msiecinski/Minisumo/README.md

# Minisumo
Source file, pcb and stl files.

## Design assumptions:
- 4 wheels
- STM32H753VIT6 MCU
- used start module
- 10 x 10 cm
- 500 g
- 4 x pololu HPCB 15:1 6V motor
- 4 x encoders(1 for each wheel)
- 6 x sharp sensor(GP2Y0D340K)
- 3 x ktir sensor
