msiecinski/Minisumo/Mechanics/README.md

# List of mechanical elements
- chassis(SLDPRT and STL)
- plow(SLDPRT and STL)
- submission(SLDPRT and STL)
