msiecinski/Minisumo/PCB/README.md

# List of PCBs
- sharp board
- main board
