msiecinski/Minisumo/Mechanics/submission.SLDASM

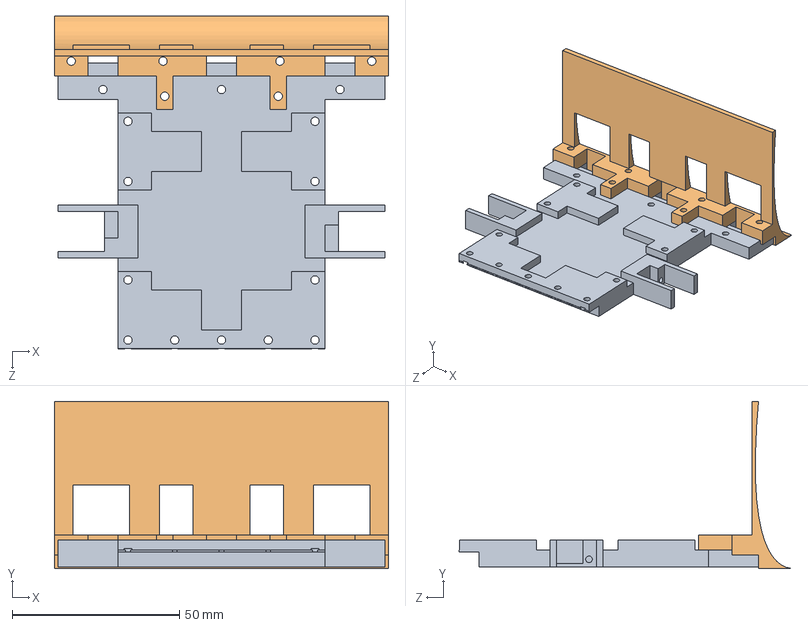
[picture p1: CAD file, 2022-06-03]
Mechanics/submission.SLDASM
100.0 x 50.0 x 99.7 mm
chassis
plow
