msiecinski/Minisumo/Mechanics/chassis.SLDPRT

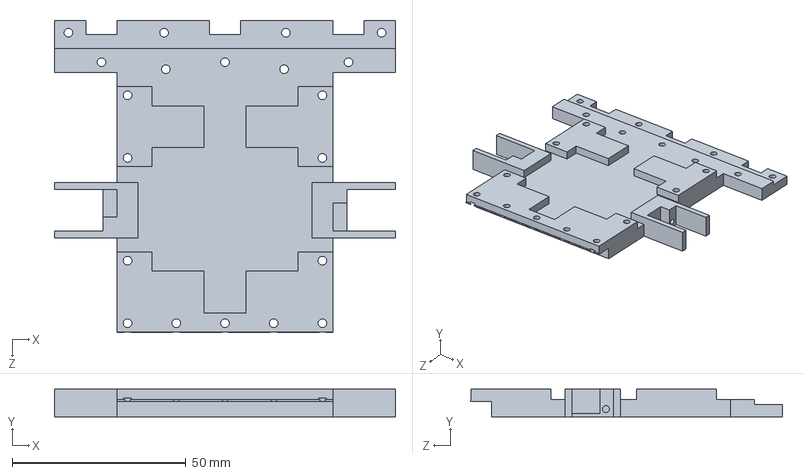
[picture p2: CAD file, 2022-06-03]
Mechanics/chassis.SLDPRT
98.0 x 8.00 x 89.6 mm
