msiecinski/Minisumo/Mechanics/plow.SLDPRT

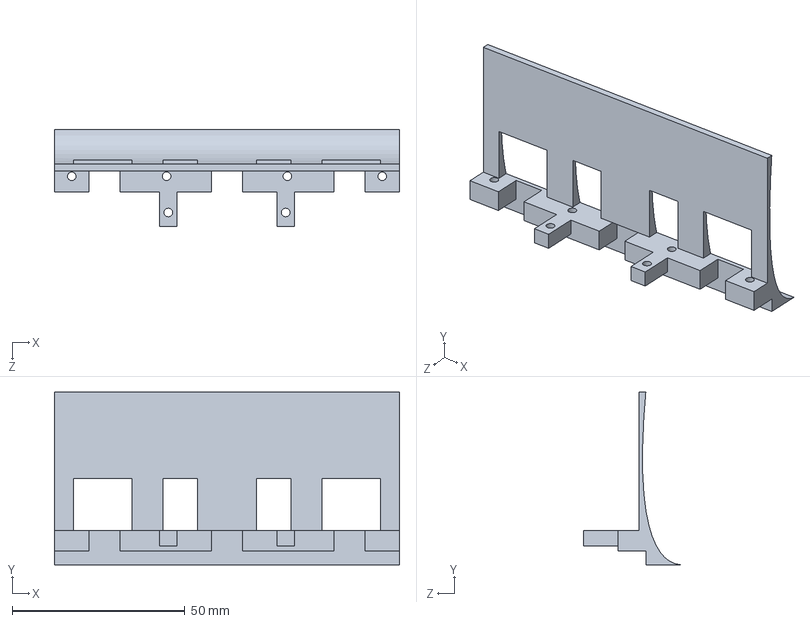
[picture p3: CAD file, 2022-06-03]
Mechanics/plow.SLDPRT
100.0 x 50.0 x 28.0 mm
