msiecinski/Minisumo/Mechanics/chassis_v2.SLDPRT

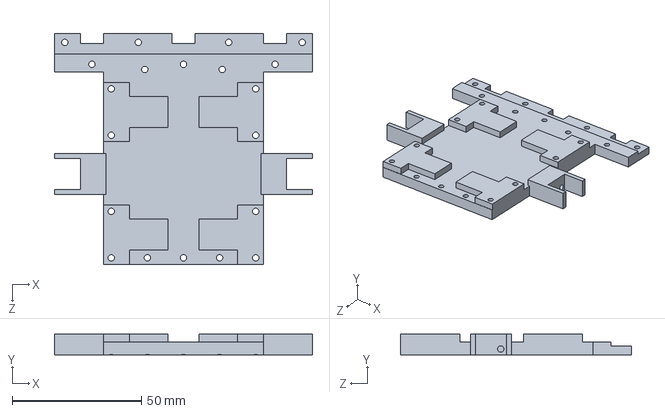
[picture p4: CAD file, 2021-10-17, an earlier design]
Mechanics/chassis_v2.SLDPRT
100.0 x 8.00 x 89.6 mm
