msiecinski/Minisumo/(list of files, cad)

Other CAD files:
Mechanics/chassis.STL
Mechanics/chassis_v2.STL
Mechanics/plow.STL
Mechanics/submission.STL
