msiecinski/Minisumo/PCB/MainBoard/MainBoard.brd

## EAGLE design PCB/MainBoard/MainBoard.brd (2022-07-14)

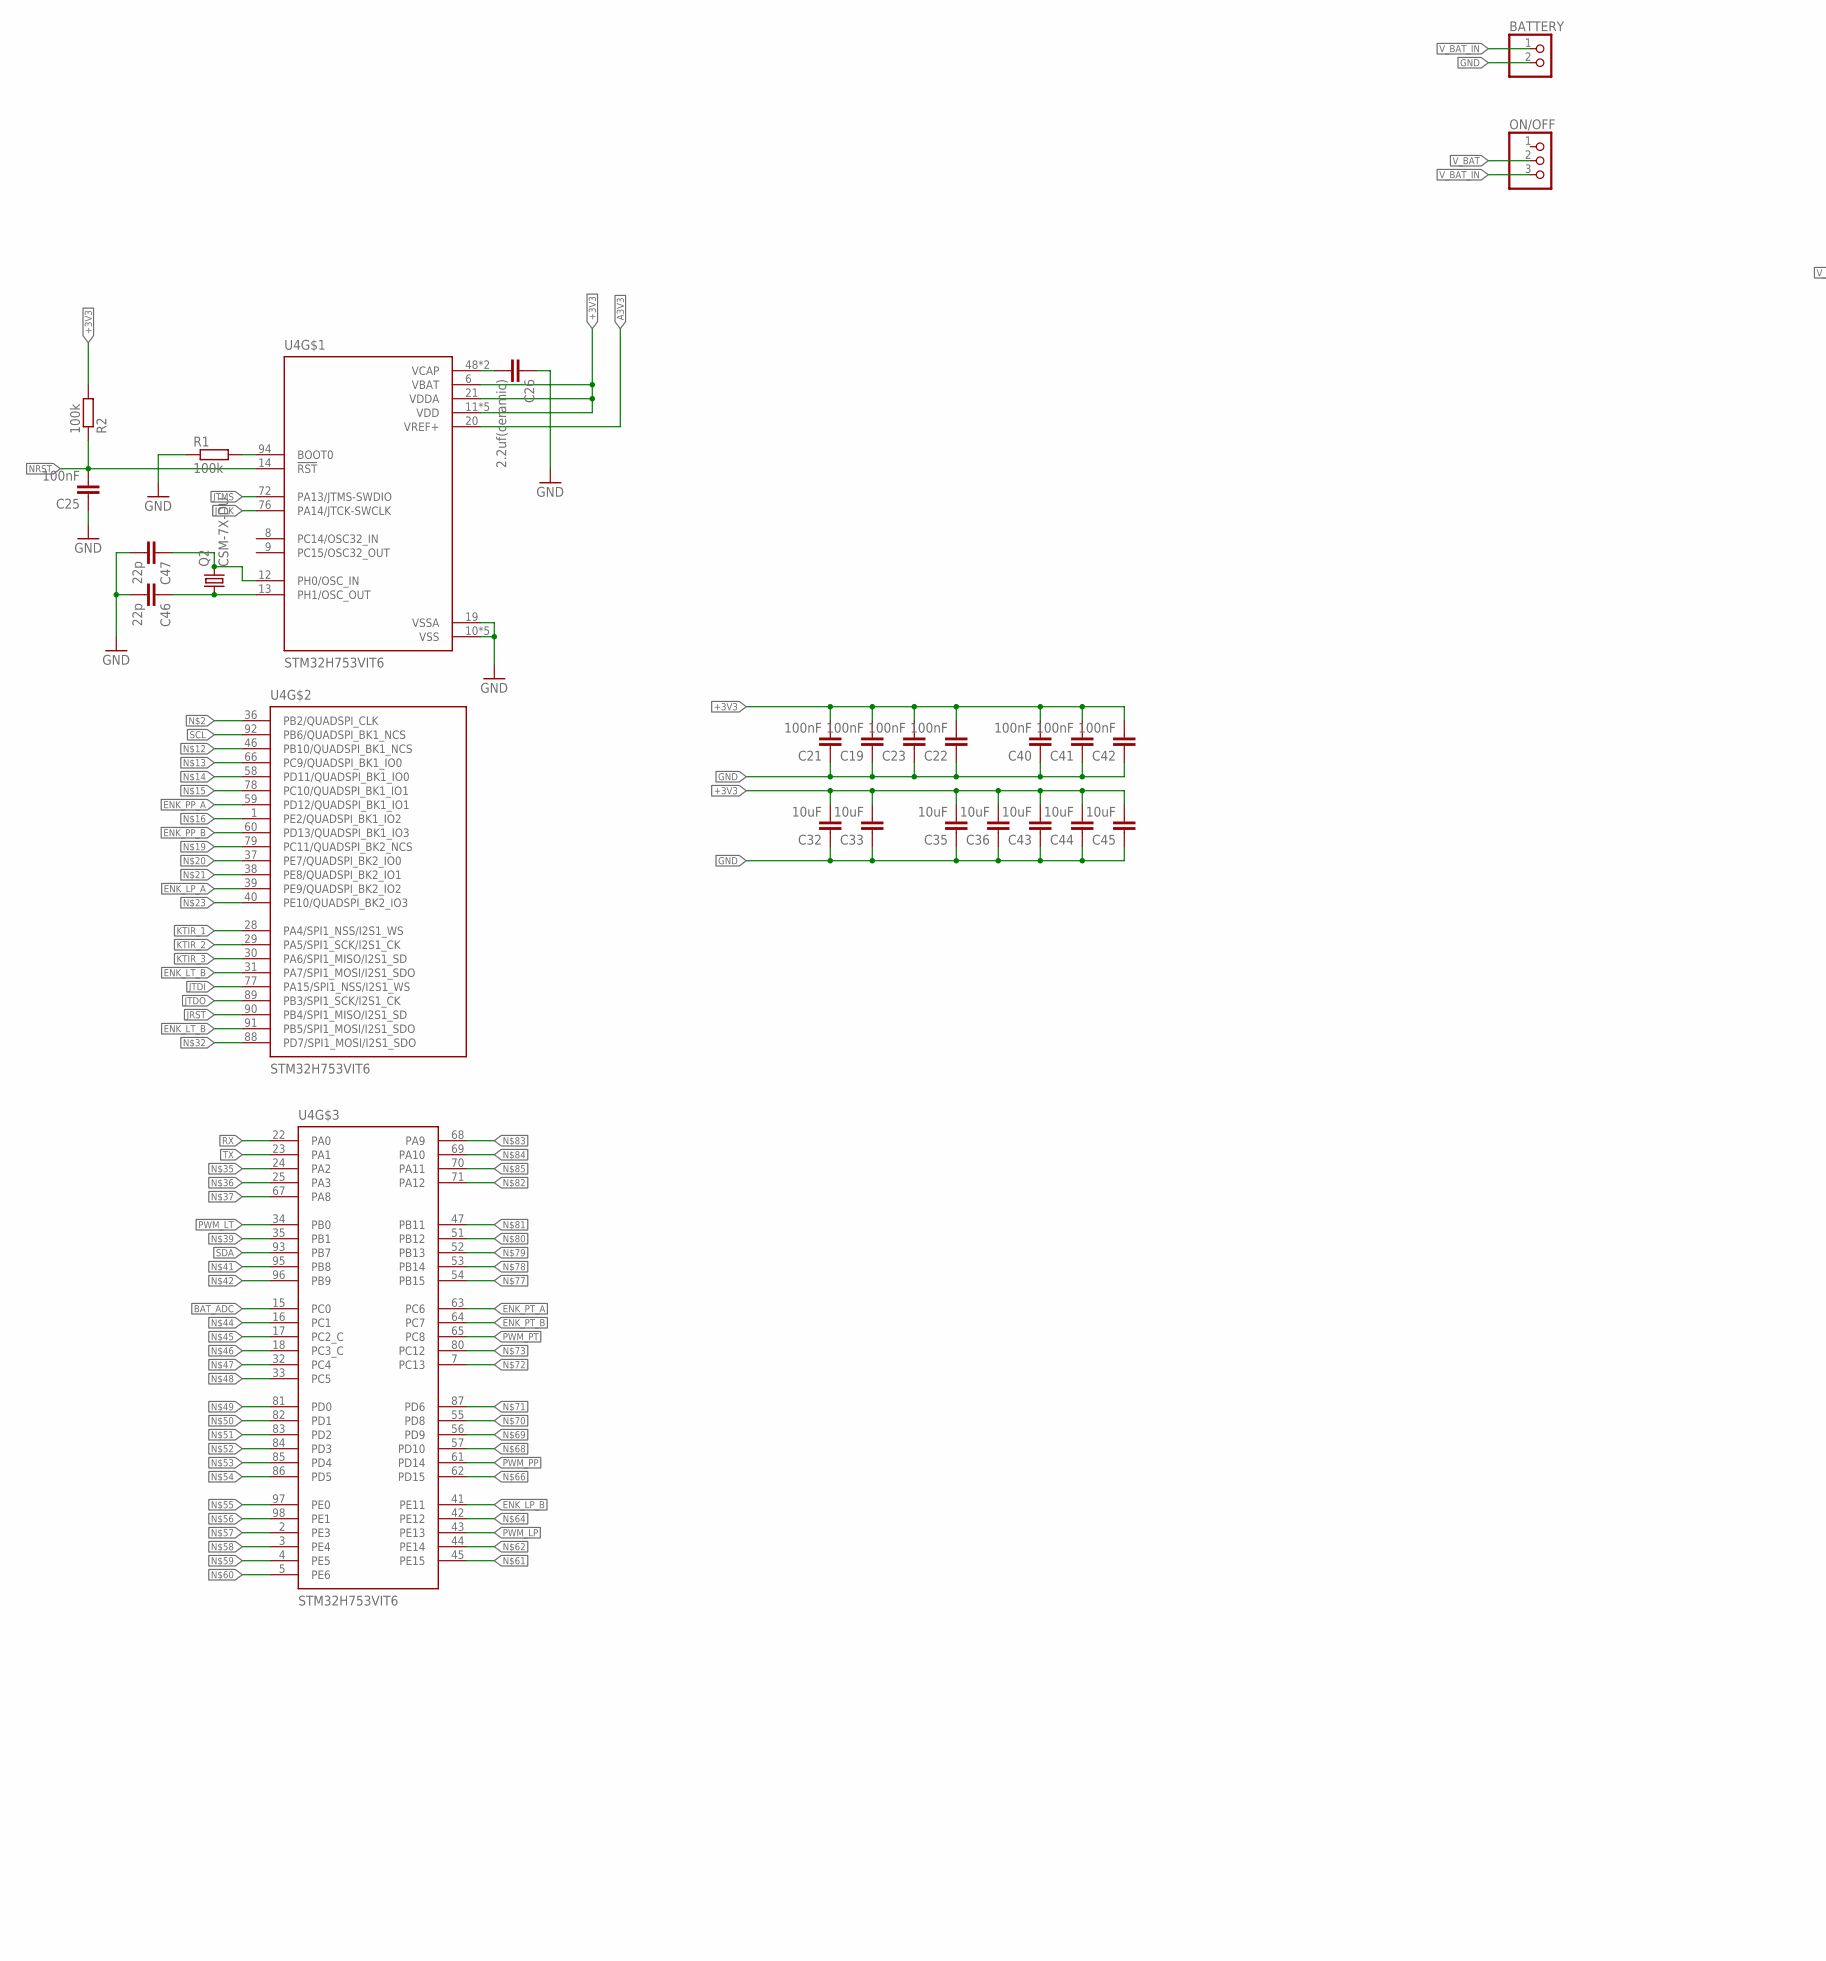
[picture p5: schematic MainBoard.sch, part in row 1, column 1]

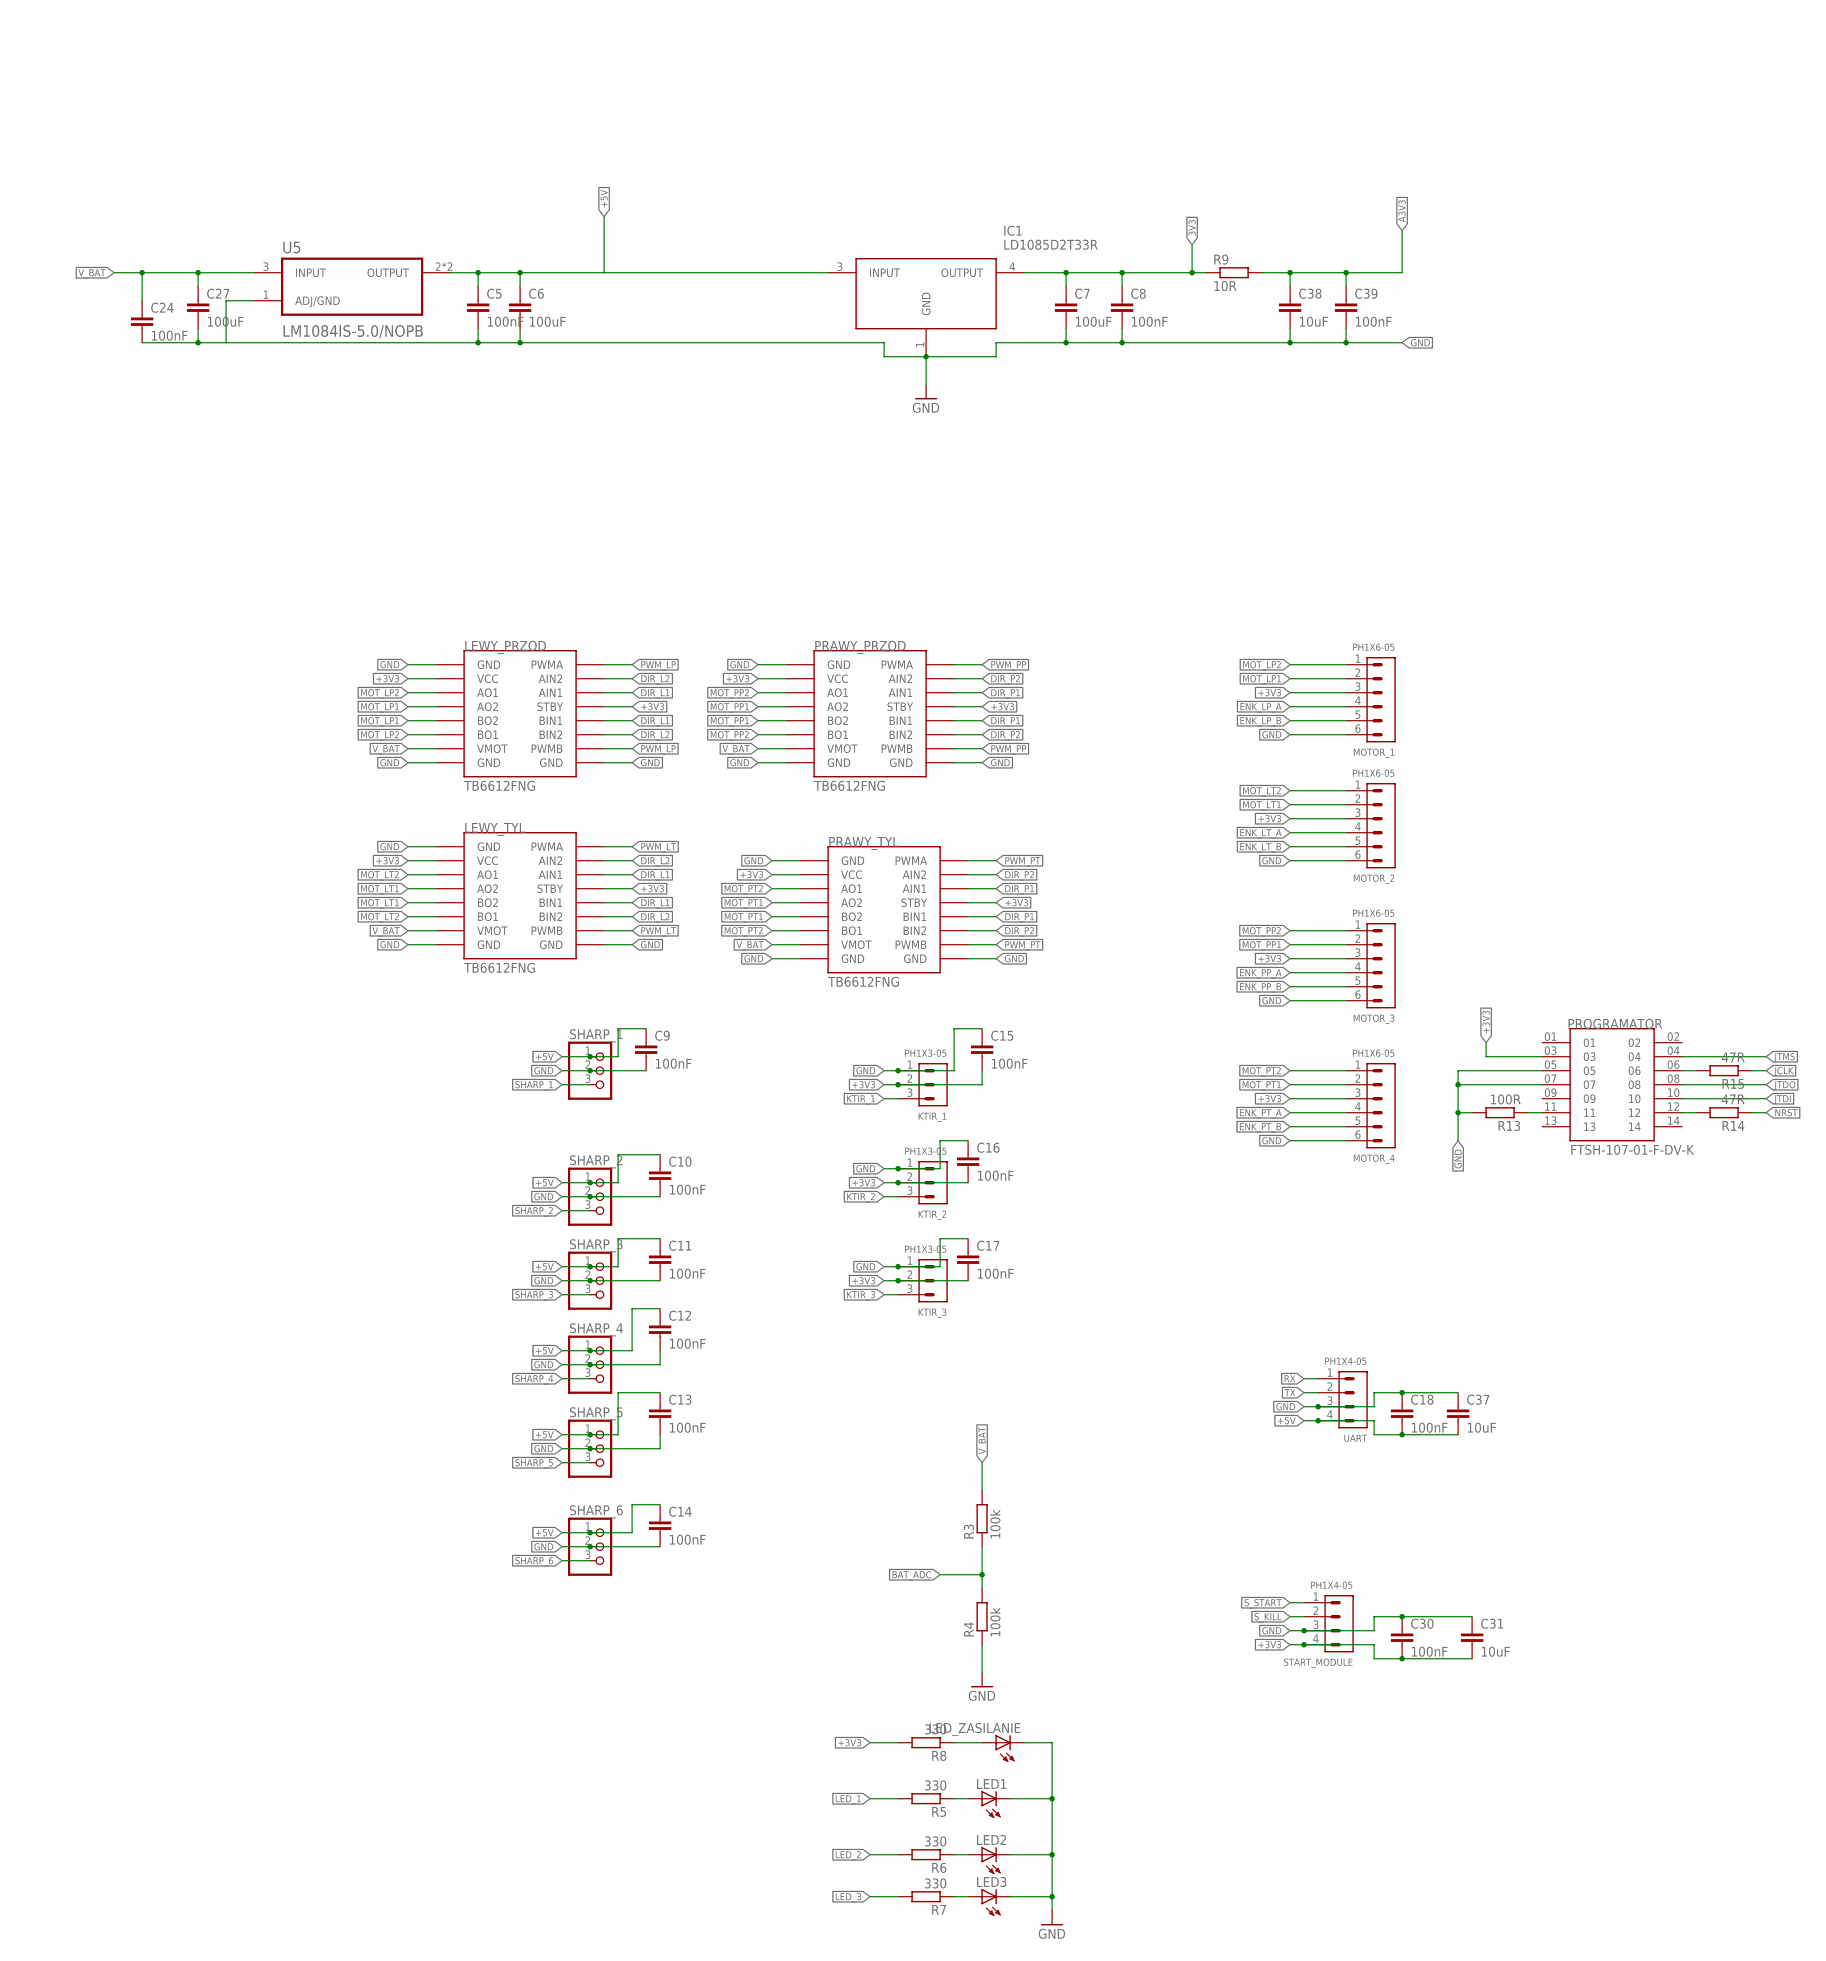
[picture p6: schematic MainBoard.sch, part in row 1, column 2]

Parts:
BATTERY: PINHD-1X2; 1X02
C5, C8, C9, C10, C11, C12, C13, C14, C15, C16, C17, C18, C19, C21, C22, C23, C24, C25, C30, C39, C40, C41, C42: 100nF; C0805
C6, C7, C27: 100uF; C0805
C26: 2.2uf(ceramic); C0805
C31, C32, C33, C35, C36, C37, C38, C43, C44, C45: 10uF; C0805
C46, C47: 22p; C0805
IC1: LD1085D2T33R
KTIR_1, KTIR_2, KTIR_3: PH1X3-05; PH005-1-3
LED1, LED2, LED3: LEDCHIPLED_0805; CHIPLED_0805
LED_ZASILANIE: LEDCHIPLED_0805; CHIPLED_0805
LEWY_PRZOD: MODUL_POLOLU
LEWY_TYL: MODUL_POLOLU
MOTOR_1, MOTOR_2, MOTOR_3, MOTOR_4: PH1X6-05; PH005-1-6
ON/OFF: PINHD-1X3; 1X03
PRAWY_PRZOD: MODUL_POLOLU
PRAWY_TYL: MODUL_POLOLU
PROGRAMATOR: FTSH-107-01-F-DV-K; SAMTEC_FTSH-107-01-F-DV-K
Q2: CSM-7X-DU
R1, R2, R3, R4: 100k; M0805
R5, R6, R7, R8: 330; M0805
R9: 10R; M0805
R13: 100R; M0805
R14, R15: 47R; M0805
SHARP_1, SHARP_2, SHARP_3, SHARP_4, SHARP_5, SHARP_6: PINHD-1X3; 1X03
START_MODULE: PH1X4-05; PH005-1-4
U4: STM32H753VIT6; QFP50P1600X1600X160-100N
U5: LM1084IS-5.0/NOPB; TO254P1524X483-4N
UART: PH1X4-05; PH005-1-4

Connections:
3V3: C7.1, C8.1, IC1.4 (OUTPUT), R9.1
+3V3: C15.2, C16.2, C17.2, C19.2, C21.2, C22.2, C23.2, C30.2, C31.2, C32.2, C33.2, C35.2, C36.2, C40.2, C41.2, C42.2, C43.2, C44.2, C45.2, KTIR_1.2, KTIR_2.2, KTIR_3.2, LEWY_PRZOD.STBY, LEWY_PRZOD.VCC, LEWY_TYL.STBY, LEWY_TYL.VCC, MOTOR_1.3, MOTOR_2.3, MOTOR_3.3, MOTOR_4.3, PRAWY_PRZOD.STBY, PRAWY_PRZOD.VCC, PRAWY_TYL.STBY, PRAWY_TYL.VCC, PROGRAMATOR.03, R2.2, R8.2, START_MODULE.4, U4.6 (VBAT), U4.11 (VDD), U4.21 (VDDA), U4.27 (VDD), U4.50 (VDD), U4.75 (VDD), U4.100 (VDD)
+5V: C5.1, C6.1, C9.1, C10.1, C11.1, C12.1, C13.1, C14.1, C18.2, C37.2, IC1.3 (INPUT), SHARP_1.1, SHARP_2.1, SHARP_3.1, SHARP_4.1, SHARP_5.1, SHARP_6.1, U5.2 (OUTPUT), U5.4 (OUTPUT), UART.4
A3V3: C38.1, C39.1, R9.2, U4.20 (VREF+)
BAT_ADC: R3.1, R4.2, U4.15 (PC0)
DIR_L1: LEWY_PRZOD.AIN1, LEWY_PRZOD.BIN1, LEWY_TYL.AIN1, LEWY_TYL.BIN1
DIR_L2: LEWY_PRZOD.AIN2, LEWY_PRZOD.BIN2, LEWY_TYL.AIN2, LEWY_TYL.BIN2
DIR_P1: PRAWY_PRZOD.AIN1, PRAWY_PRZOD.BIN1, PRAWY_TYL.AIN1, PRAWY_TYL.BIN1
DIR_P2: PRAWY_PRZOD.AIN2, PRAWY_PRZOD.BIN2, PRAWY_TYL.AIN2, PRAWY_TYL.BIN2
ENK_LP_A: MOTOR_1.4, U4.39 (PE9/QUADSPI_BK2_IO2)
ENK_LP_B: MOTOR_1.5, U4.41 (PE11)
ENK_LT_A: MOTOR_2.4
ENK_LT_B: MOTOR_2.5, U4.31 (PA7/SPI1_MOSI/I2S1_SDO), U4.91 (PB5/SPI1_MOSI/I2S1_SDO)
ENK_PP_A: MOTOR_3.4, U4.59 (PD12/QUADSPI_BK1_IO1)
ENK_PP_B: MOTOR_3.5, U4.60 (PD13/QUADSPI_BK1_IO3)
ENK_PT_A: MOTOR_4.4, U4.63 (PC6)
ENK_PT_B: MOTOR_4.5, U4.64 (PC7)
GND: BATTERY.2, C5.2, C6.2, C7.2, C8.2, C9.2, C10.2, C11.2, C12.2, C13.2, C14.2, C15.1, C16.1, C17.1, C18.1, C19.1, C21.1, C22.1, C23.1, C25.1, C26.1, C30.1, C31.1, C32.1, C33.1, C35.1, C36.1, C37.1, C38.2, C39.2, C40.1, C41.1, C42.1, C43.1, C44.1, C45.1, C46.2, C47.2, IC1.1 (GND), KTIR_1.1, KTIR_2.1, KTIR_3.1, LED1.C, LED2.C, LED3.C, LED_ZASILANIE.C, LEWY_PRZOD.GND1 (GND), LEWY_PRZOD.GND2 (GND), LEWY_PRZOD.GND3 (GND), LEWY_TYL.GND1 (GND), LEWY_TYL.GND2 (GND), LEWY_TYL.GND3 (GND), MOTOR_1.6, MOTOR_2.6, MOTOR_3.6, MOTOR_4.6, PRAWY_PRZOD.GND1 (GND), PRAWY_PRZOD.GND2 (GND), PRAWY_PRZOD.GND3 (GND), PRAWY_TYL.GND1 (GND), PRAWY_TYL.GND2 (GND), PRAWY_TYL.GND3 (GND), PROGRAMATOR.05, PROGRAMATOR.07, R1.1, R4.1, R13.2, SHARP_1.2, SHARP_2.2, SHARP_3.2, SHARP_4.2, SHARP_5.2, SHARP_6.2, START_MODULE.3, U4.10 (VSS), U4.19 (VSSA), U4.26 (VSS), U4.49 (VSS), U4.74 (VSS), U4.99 (VSS), UART.3
JCLK: R15.1, U4.76 (PA14/JTCK-SWCLK)
JRST: U4.90 (PB4/SPI1_MISO/I2S1_SD)
JTDI: PROGRAMATOR.10, U4.77 (PA15/SPI1_NSS/I2S1_WS)
JTDO: PROGRAMATOR.08, U4.89 (PB3/SPI1_SCK/I2S1_CK)
JTMS: PROGRAMATOR.04, U4.72 (PA13/JTMS-SWDIO)
KTIR_1: KTIR_1.3, U4.28 (PA4/SPI1_NSS/I2S1_WS)
KTIR_2: KTIR_2.3, U4.29 (PA5/SPI1_SCK/I2S1_CK)
KTIR_3: KTIR_3.3, U4.30 (PA6/SPI1_MISO/I2S1_SD)
LED_1: R5.2
LED_2: R6.2
LED_3: R7.2
MOT_LP1: LEWY_PRZOD.A02 (AO2), LEWY_PRZOD.BO2, MOTOR_1.2
MOT_LP2: LEWY_PRZOD.AO1, LEWY_PRZOD.BO1, MOTOR_1.1
MOT_LT1: LEWY_TYL.A02 (AO2), LEWY_TYL.BO2, MOTOR_2.2
MOT_LT2: LEWY_TYL.AO1, LEWY_TYL.BO1, MOTOR_2.1
MOT_PP1: MOTOR_3.2, PRAWY_PRZOD.A02 (AO2), PRAWY_PRZOD.BO2
MOT_PP2: MOTOR_3.1, PRAWY_PRZOD.AO1, PRAWY_PRZOD.BO1
MOT_PT1: MOTOR_4.2, PRAWY_TYL.A02 (AO2), PRAWY_TYL.BO2
MOT_PT2: MOTOR_4.1, PRAWY_TYL.AO1, PRAWY_TYL.BO1
unnamed: PROGRAMATOR.11, R13.1
unnamed: R1.2, U4.94 (BOOT0)
unnamed: C26.2, U4.48 (VCAP), U4.73 (VCAP)
unnamed: LED1.A, R5.1
unnamed: LED2.A, R6.1
unnamed: LED3.A, R7.1
unnamed: PROGRAMATOR.12, R14.2
unnamed: LED_ZASILANIE.A, R8.1
unnamed: C47.1, Q2.2, U4.12 (PH0/OSC_IN)
unnamed: C46.1, Q2.1, U4.13 (PH1/OSC_OUT)
unnamed: PROGRAMATOR.06, R15.2
unnamed: C24.2, C27.2, U5.1 (ADJ/GND)
NRST: C25.2, R2.1, R14.1, U4.14 (!RST)
PWM_LP: LEWY_PRZOD.PWMA, LEWY_PRZOD.PWMB, U4.43 (PE13)
PWM_LT: LEWY_TYL.PWMA, LEWY_TYL.PWMB, U4.34 (PB0)
PWM_PP: PRAWY_PRZOD.PWMA, PRAWY_PRZOD.PWMB, U4.61 (PD14)
PWM_PT: PRAWY_TYL.PWMA, PRAWY_TYL.PWMB, U4.65 (PC8)
RX: U4.22 (PA0), UART.1
SCL: U4.92 (PB6/QUADSPI_BK1_NCS)
SDA: U4.93 (PB7)
SHARP_1: SHARP_1.3
SHARP_2: SHARP_2.3
SHARP_3: SHARP_3.3
SHARP_4: SHARP_4.3
SHARP_5: SHARP_5.3
SHARP_6: SHARP_6.3
S_KILL: START_MODULE.2
S_START: START_MODULE.1
TX: U4.23 (PA1), UART.2
V_BAT: C24.1, C27.1, LEWY_PRZOD.VMOT, LEWY_TYL.VMOT, ON/OFF.2, PRAWY_PRZOD.VMOT, PRAWY_TYL.VMOT, R3.2, U5.3 (INPUT)
V_BAT_IN: BATTERY.1, ON/OFF.3

Board: 2 copper layers, 89 parts (11 on the bottom side), 53 nets, no tracks yet.

Other parts of the board:
U$1, U$2, U$3, U$4, U$5, U$6, U$7, U$8: 2,8
