msiecinski/Minisumo/(commit log)

2021-10-08 Added cad files with v1 version robot chassis.
    [chassis.SLDPRT, chassis.STL]
2021-10-08 Added PCB with sharp sensor and readme file.
    [sharpboard.brd, sharpboard.sch]
2021-10-09 Added second version of chassis.
    [chassis.SLDPRT]
2021-10-09 Added second version of chassis.
    [chassis_v2.SLDPRT, chassis_v2.STL]
2021-10-09 Update holes size
    [chassis_v2.SLDPRT]
2021-10-10 Some minior changes
    [chassis_v2.SLDPRT, chassis_v2.STL]
2021-10-13 Increase space for sharp sensor
    [chassis_v2.SLDPRT]
2021-10-13 Move (0.5mm) forvard motors
    [chassis_v2.SLDPRT]
2021-10-15 Changes in chassis_v2 project -added mount hole for sharp sensor and upgrade place for sharp -delete part of holes for pcb -edit place for ktir and plow(less thickness 2.5->2mm) -shortened back of ch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
    [chassis_v2.SLDPRT, chassis_v2.STL]
2021-10-17 Change place designed for plow
    [chassis_v2.SLDPRT, chassis_v2.STL]
2021-10-17 Work on main board pcb
    [MainBoard.sch]
2022-03-08 Changing naming chassis V2(actual version)
    [chassis.SLDPRT, chassis.STL]
2022-03-08 3d files update
    -increase hole for screw size
    -update place for sharps
    -narrowing by 6mm(3 on both size)
    -rear height increase
    -plew screw position change
    [chassis.SLDPRT, chassis.STL]
2022-03-08 Update 3d files
    -increase length sharp srew hole
    [chassis.SLDPRT, chassis.STL]
2022-03-10 Update readme
    - change selected MCU(STM32F4 instead of STM32H7)
    - added info about sharp sensor and ktir sensor
2022-03-10 Update 3d files
    -decrease srew hgole size for sharp
    -place for sharp on front
    [chassis.SLDPRT, chassis.STL]
2022-03-16 Update cad files
    Update backside:
    -lining(3.5m->4.5mm)
    -place for hole(5mm->5.5mm)
    [chassis.SLDPRT, chassis.STL]
2022-03-24 Update cad files
    -place for sharo sensor
    -move 2 holes for plow/pcb
    [chassis.SLDPRT, chassis.STL]
2022-03-27 Added plow and submission
    -added plow v1
    -added submussion(plow + chassis)
    [plow.SLDPRT, plow.STL, submission.SLDASM, submission.STL]
2022-06-03 Update cad files
    Chassis:
    - remove place for sharo sensor
    -change posiotion 2 holes for mount plow(increase 9mm)
    Plow:
    -update postion hole for plow mount(increase by 9mm)
    [chassis.SLDPRT, chassis.STL, plow.SLDPRT, plow.STL, submission.SLDASM]
2022-06-03 Update README.md
    Change using in project MCU(STM32F466->STM32H7A3VIT6)
2022-06-03 Update README.md
    Fix error(STM32H753VIT6 no STM32H7A3VIT6)
2022-07-06 Main board updates
    -change mcu(STM32H753)
    [MainBoard.brd, MainBoard.sch]
2022-07-06 Update eagle files
    [MainBoard.brd, MainBoard.sch]
2022-07-12 PCB update
    -place elements on the board
    [MainBoard.brd, MainBoard.sch]
2022-07-13 Update pcb files
    - edit positions on the board
    [MainBoard.brd, MainBoard.sch]
2022-07-14 Update eagle files
    -delete gyroscope
    [MainBoard.brd, MainBoard.sch]
